pinmode-by/sumo-start-module/README.md

# Стартовый модуль и судейский пульт

#### В этом репозитории вы найдете необходимые материалы для самостоятельного изготовления стартового модуля и судейского пульта стандарта Robotchallenge. Оборудование соответствует требованиям многих мировых соревнований:
+ Robotchallenge (Китай)
+ Robochallenge (Румыния)
+ Robotex (Эстония, Кипр, Турция, Индия, Греция, Китай)
+ Робофинист (Россия)
+ Кубок по образовательной робототехнике (Беларусь)

Используется ИК-канал связи на частоте 38 кГц и протокол RC-5

## [DIY_edition](/DIY_edition/) - вместо стартового модуля используется датчик TSOP xx38, а пульт собирается на Arduino nano
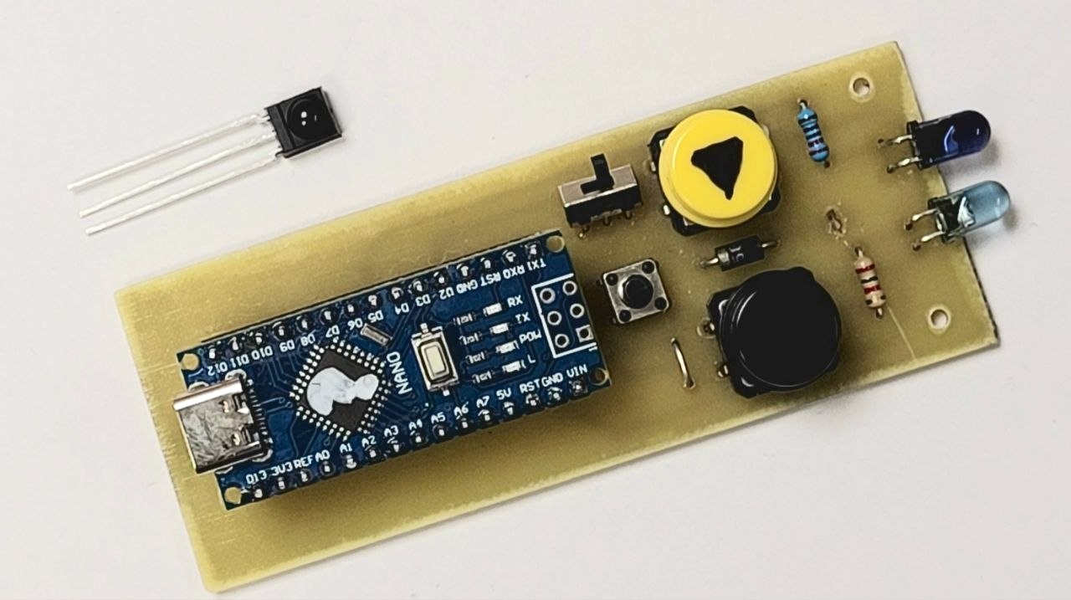
[picture p1: DIY_edition/Referee_remote/Hardware/img/TSOP_and_DIY_referee_RC.jpg]


## [pinMode_edition](/pinMode_edition/) - модуль и пульт, разработанные в клубе pinMode (Беларусь)
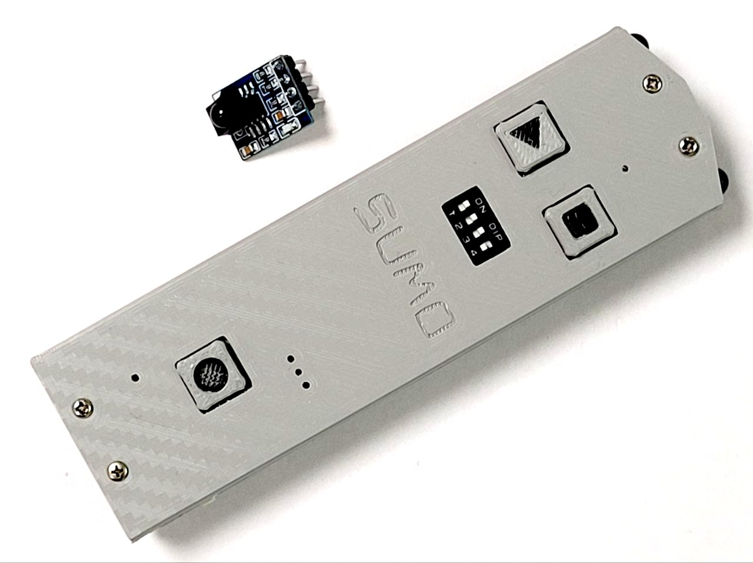
[picture p2: pinMode_edition/Referee_remote/Hardware/img/photo_pinMode_module_and_RC.jpg]

Печатные платы можно заказать на производстве, запаять, прошить их.
