pinmode-by/sumo-start-module/DIY_edition/Readme.md

# [Стартовый модуль](/DIY_edition/Hardware/tsop48.pdf) представляет собой ИК-приемник на 38 кГц

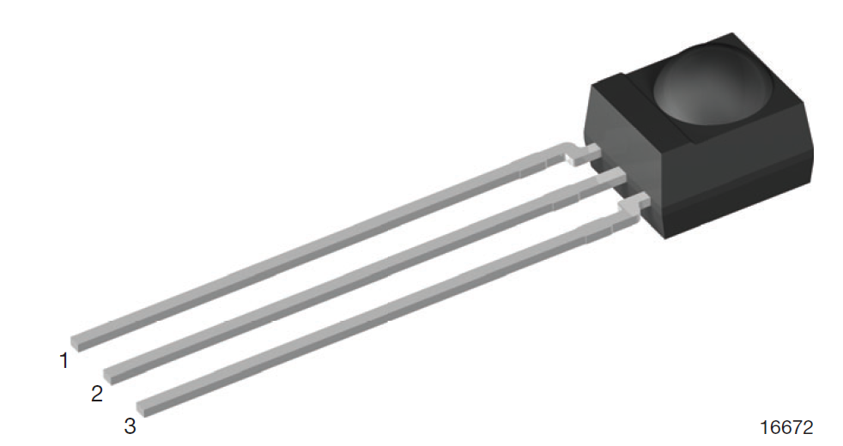
[picture p3: DIY_edition/Hardware/img/TSOP_XX38.png]


[Программа для Arduino IDE](/DIY_edition/Software/TSOP_as_start_module.ino)

-------
# [Судейский пульт](/DIY_edition/Hardware/Schematic_DIY_referee_remote.pdf) на Arduino nano

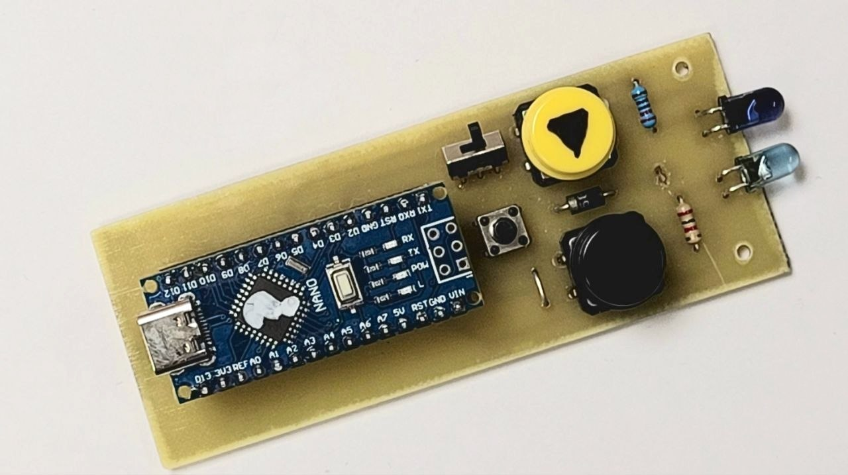
[picture p4: DIY_edition/Referee_remote/Hardware/img/DIY_referee_RC.jpg]


[Программа для Arduino IDE](/DIY_edition/Software/Referee_remote.ino)

| Файл | Назначение |
|---|---|
| [Schematic_DIY_referee_remote.pdf](/DIY_edition/Hardware/Schematic_DIY_referee_remote.pdf)| Принципиальная схема |
| [BOM_DIY_referee_RC.pdf](/DIY_edition/Hardware/BOM_DIY_referee_RC.pdf)| Список деталей |
| [PCB_DIY_Referee_remote_top_layer.pdf](/DIY_edition/Hardware/PCB_DIY_Referee_remote_top_layer.pdf) | Расположение деталей на верхнем слое |
| [PCB_DIY_Referee_remote_bottom_layer.pdf](/DIY_edition/Hardware/PCB_DIY_Referee_remote_bottom_layer.pdf) | Нижний слой платы для ЛУТ |
