pinmode-by/sumo-start-module/pinMode_edition/Start_module/Readme.md

# Стартовый модуль от клуба pinMode

1. Имеет небольшой размер
2. Состоит из доступных компонентов
3. Может запаиваться вручную
4. Совместим по выводам с модулем Robotchallenge

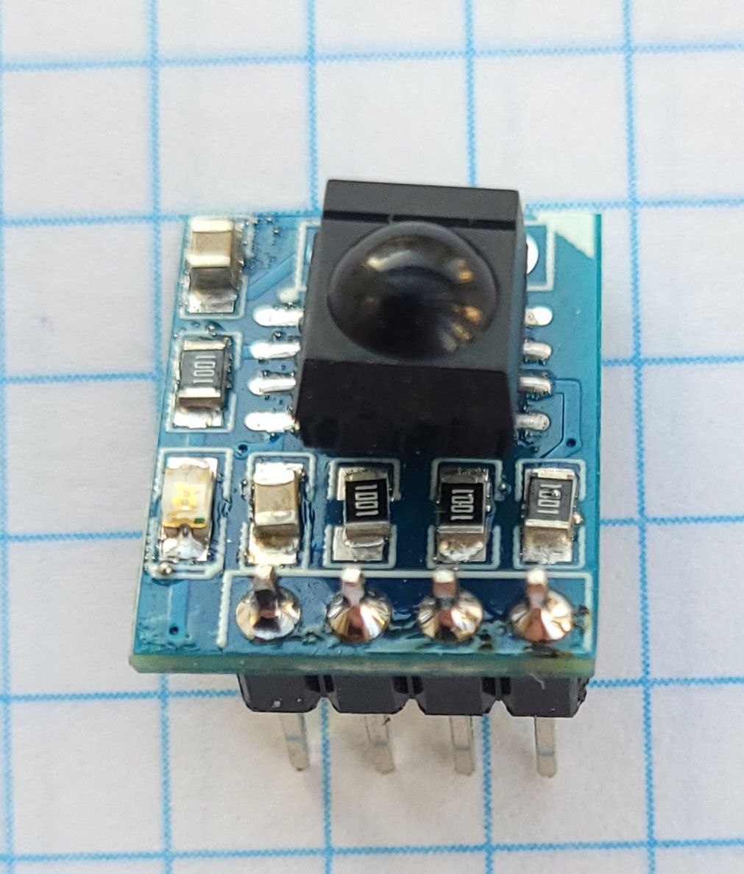
[picture p5: pinMode_edition/Start_module/Hardware/img/Start_module.jpg]


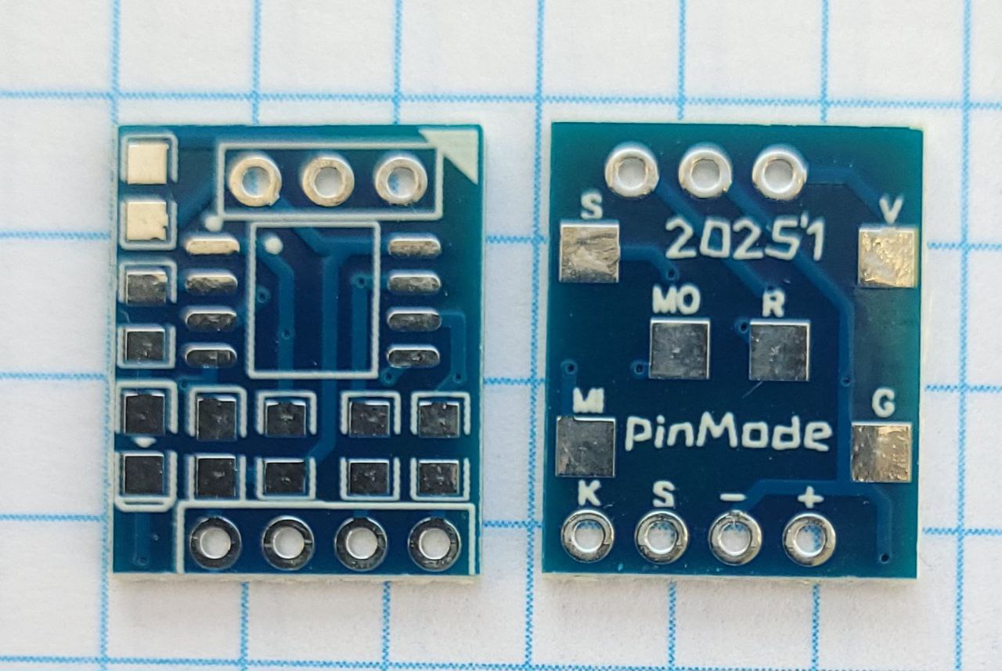
[picture p6: pinMode_edition/Start_module/Hardware/img/PCB_view.jpg]
