pinmode-by/sumo-start-module/pinMode_edition/Referee_remote/Hardware/Readme.md

# Судейский пульт от клуба pinMode

1. Приятно лежит в руке из-за небольших габаритов
2. Имеет 3 мощных ИК-светодиода для запуска и остановки роботов
3. Имеет 1 ИК-светодиод для установки номера ринга
4. Построен на микроконтроллере Atmega168
5. Позволяет выбирать номер ринга от 0 до 15 
6. Работает от LiPo аккумулятора 
7. Имеет зарядное устройство
8. Заряжается через USB type C

| Файл | Содержание |
|---|---|
| [Schematic_Referee_Sumo_RC.pdf](/pinMode_edition/Referee_remote/Hardware/Schematic_Referee_Sumo_RC.pdf) | Принципиальная схема пульта |
| [BOM_Referee_sumo_RC.pdf](/pinMode_edition/Referee_remote/Hardware/BOM_referee_sumo_RC.pdf) | Список компонентов |
| [PickAndPlace_Referee_sumo_RC.pdf](/pinMode_edition/Referee_remote/Hardware/PickAndPlace_Referee_sumo_RC.pdf) | Таблица размещения компонентов|
| [Gerber_Rereree_Sumo_RC.zip](/pinMode_edition/Referee_remote/Hardware/Gerber_Rereree_Sumo_RC.zip)| Gerber-файл для производства|
