pinmode-by/sumo-start-module/pinMode_edition/Start_module/Hardware/readme.md

# RobotChallenge start module by pinMode:

!\[PCB view](/pinMode\_edition/Start\_module/Hardware/img/PCB\_view.jpg)

!\[Module view](/Hardware/Prebuilt\_Module/pinMode\_edition/img/Start\_module.jpg)
