pinmode-by/sumo-start-module/pinMode_edition/Start_module/Hardware/Start_module_eng.pdf

## RobotChallenge sumo start module by pinMode.by

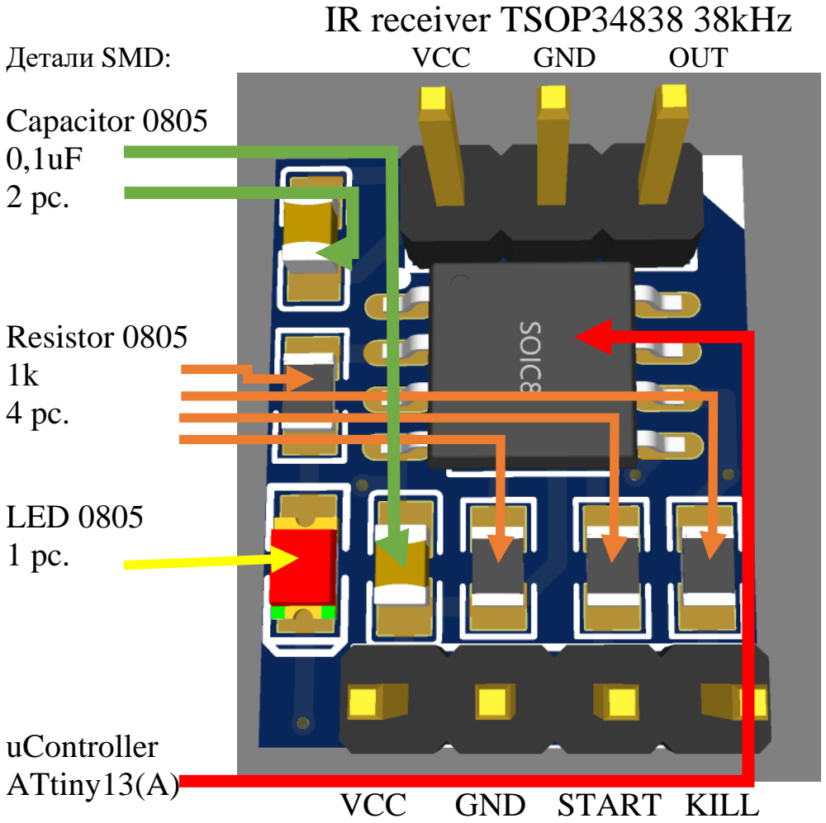
[picture p7: figure]
IR receiver TSOP34838 38kHz; Детали SMD:; VCC; GND; OUT; Capacitor 0805 0,1uF 2 pc.; Resistor 0805 1k 4 pc.; LED 0805 1 pc.; uController; ATtiny13(A); GND START KILL
