pinmode-by/sumo-start-module/pinMode_edition/Start_module/Hardware/Start_module_rus.pdf

## Стартовый модуль микро-, мини- и мега- сумо

## по регламету RobotChallenge

Модуль разработан как замена стандартному https://p1r.se/startmodule/ с использованием доступных в 2025 году деталей

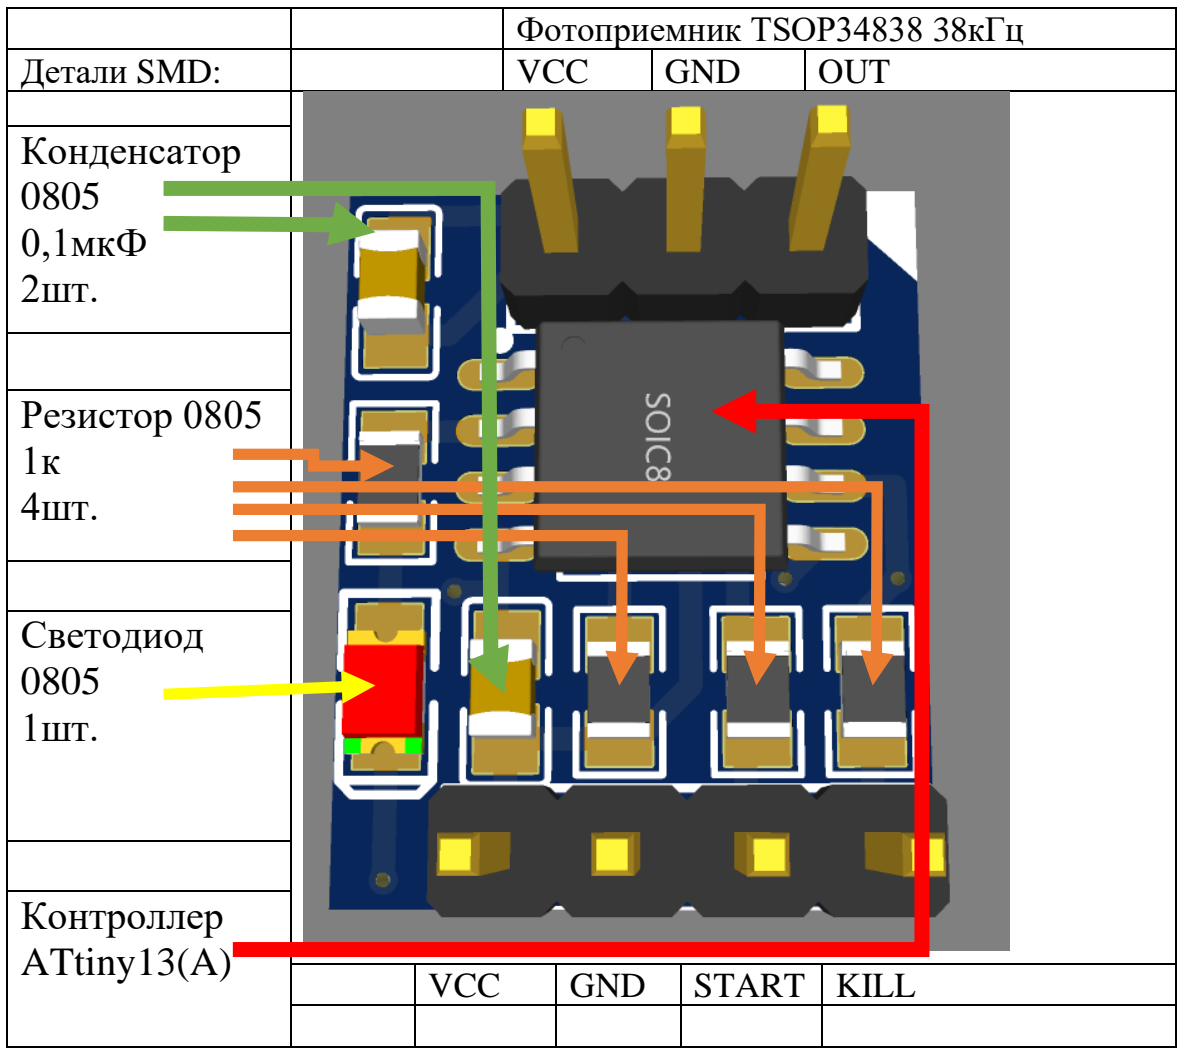
[picture p8: figure]
Фотоприемник TSOP34838 38кГц; Детали SMD:; VCC; GND; OUT; Конденсатор 0805 0,1мкФ 2шт.; Резистор 0805 1к 4шт.; Светодиод 0805 1шт.; Контроллер; ATtiny13(A); START; KILL
