pinmode-by/sumo-start-module/pinMode_edition/Readme.md

# [Стартовый модуль](/pinMode_edition/Start_module/) и [судейский пульт](/pinMode_edition/Referee_remote/) от клуба pinMode



1. Соответствуют международным регламентам
2. Печатные платы изготавливаются промышленным способом
3. Построены из доступных компонентов
4. Возможна ручная сборка (детали не меньше 0805)
