pinmode-by/sumo-start-module/pinMode_edition/Referee_remote/Readme.md

# Судейский пульт от клуба pinMode
* [Оборудование](/pinMode_edition/Referee_remote/Hardware/)
* [Программное обеспечение](/pinMode_edition/Referee_remote/Software/)

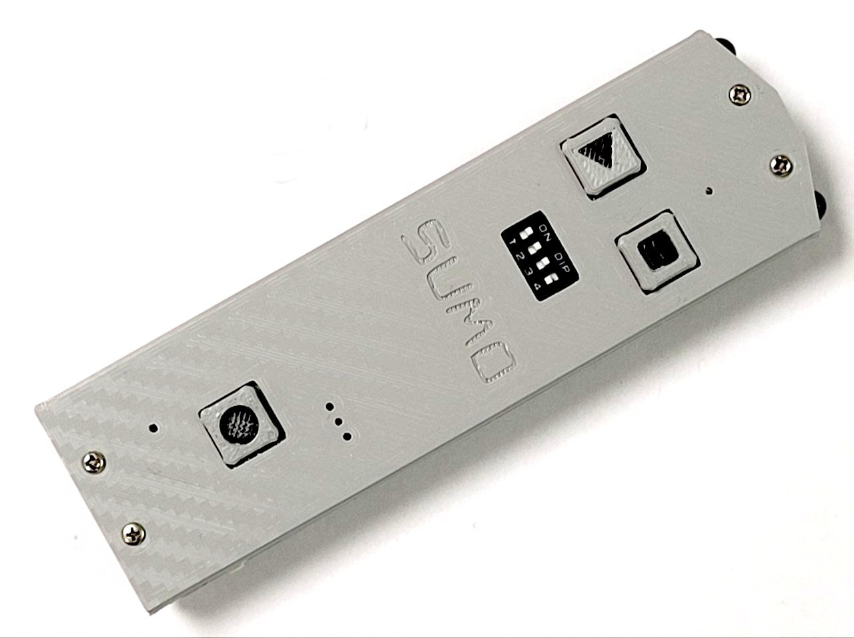
[picture p9: pinMode_edition/Referee_remote/Hardware/img/photo_pinMode_RC.jpg]
