pinmode-by/sumo-start-module/DIY_edition/Referee_remote/Hardware/DIY_Referee_remote.png

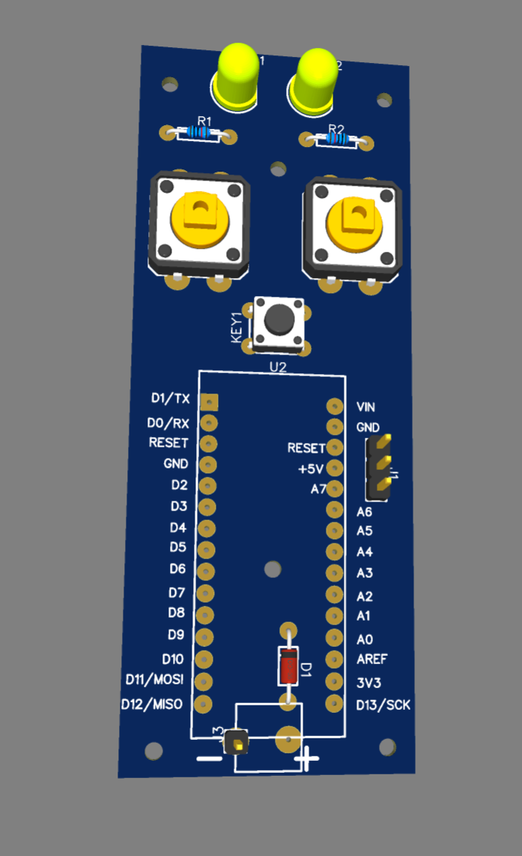
DIY_edition/Referee_remote/Hardware/DIY_Referee_remote.png
