pinmode-by/sumo-start-module/DIY_edition/Referee_remote/Hardware/img/photo_DIY_module_and_RC.jpg

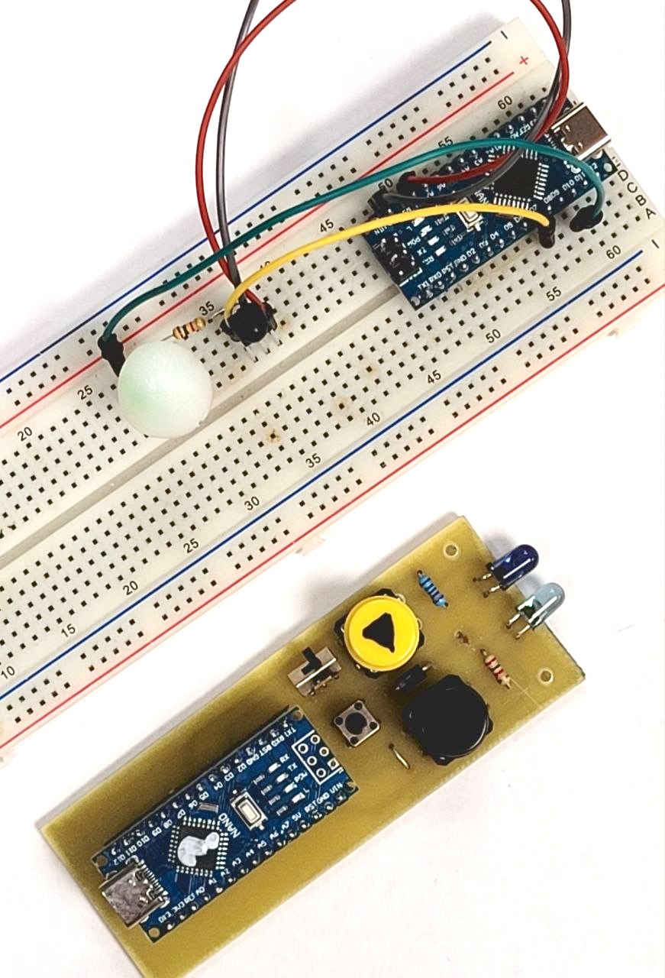
DIY_edition/Referee_remote/Hardware/img/photo_DIY_module_and_RC.jpg
