pinmode-by/sumo-start-module/pinMode_edition/Referee_remote/Hardware/img/photo_Device.jpg

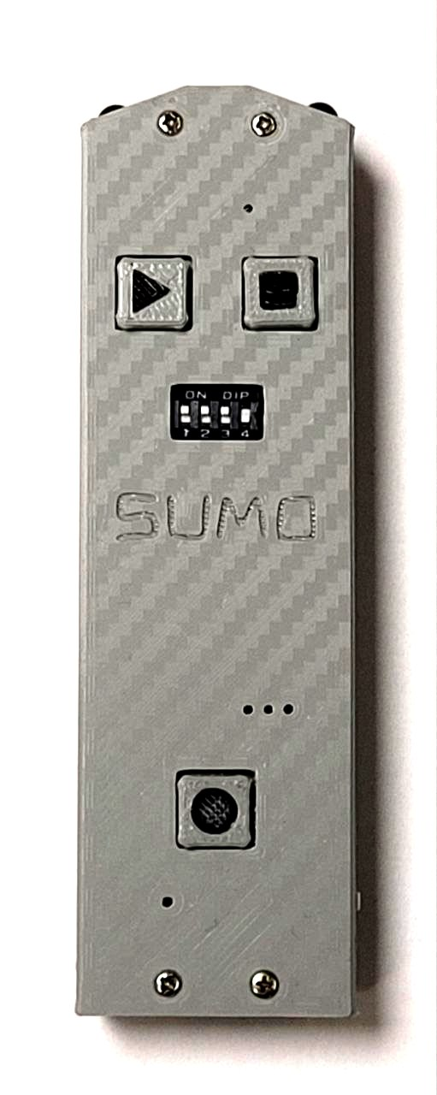
pinMode_edition/Referee_remote/Hardware/img/photo_Device.jpg
