pinmode-by/sumo-start-module/pinMode_edition/Referee_remote/Hardware/img/photo_PCB_Referee_sumo_RC.jpg

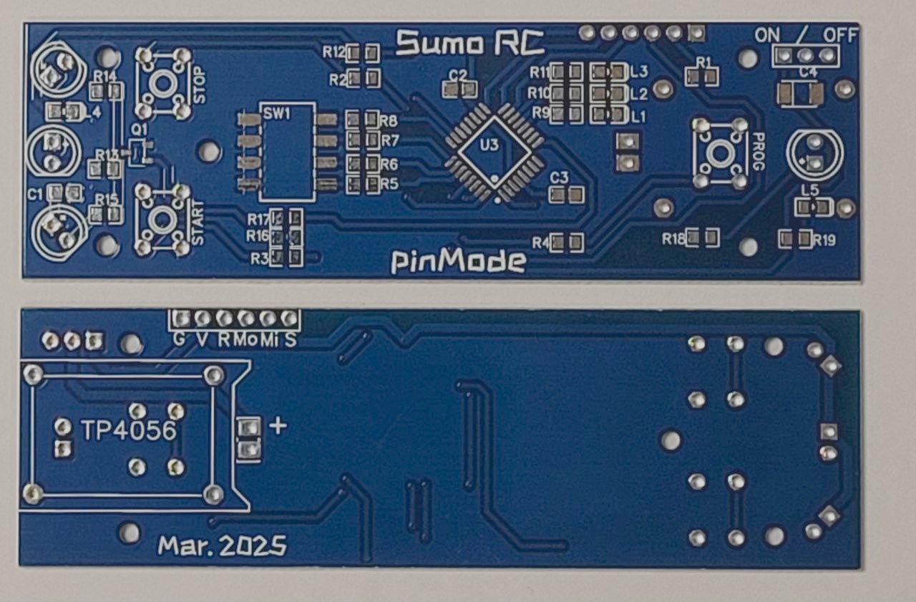
pinMode_edition/Referee_remote/Hardware/img/photo_PCB_Referee_sumo_RC.jpg
