pinmode-by/sumo-start-module/pinMode_edition/Start_module/Hardware/Programmer/photo_Start_module_Programmer.jpg

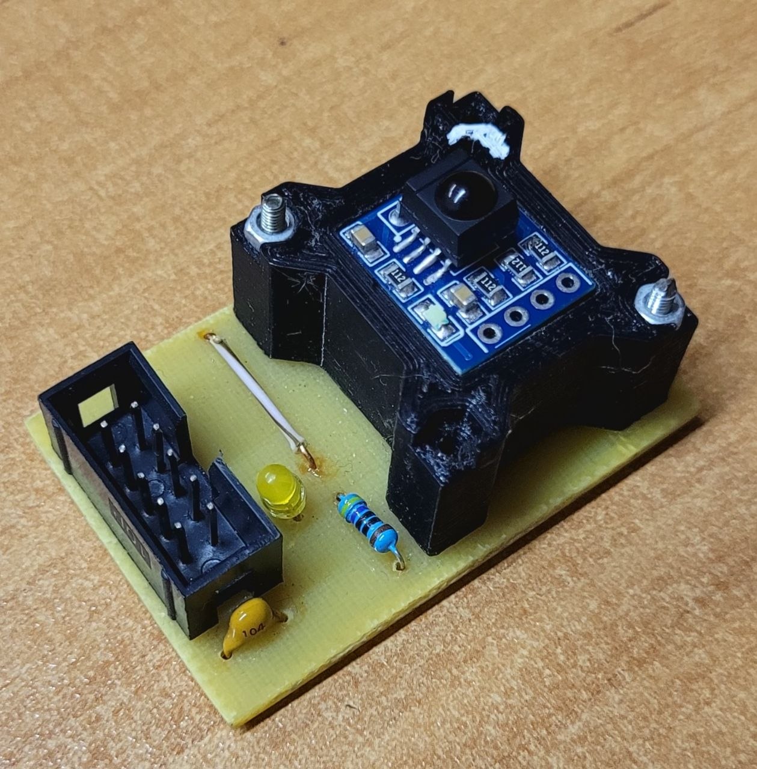
pinMode_edition/Start_module/Hardware/Programmer/photo_Start_module_Programmer.jpg
