pinmode-by/sumo-start-module/pinMode_edition/Start_module/Hardware/start_module.png

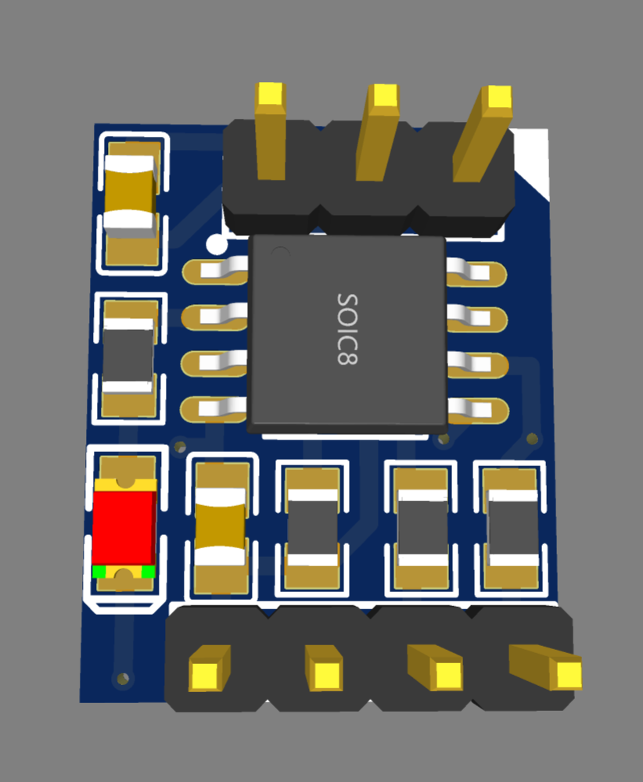
pinMode_edition/Start_module/Hardware/start_module.png
