pinmode-by/sumo-start-module/DIY_edition/Hardware/BOM_DIY_referee_RC.pdf

ID | Name | Designator | Footprint | Quantity
1 1N4148 | | D1 | DO-35 | 1
2 HDR-M-2.54_1x1 | | J3 | HDR-M-2.54_1X1 | 1
3 HDR-M-2.54_1x3 | | J1 | HDR-M-2.54_1X3 | 1
4 K4-6×6_TH | | KEY1 | KEY-TH_4P-L6.0-W6.0-P4.50 | 1
5 K4-12×12_TH | | KEY2,KEY3 | KEY-TH_4P-L12.0-W12.0-P5.00 | 2
6 TSAL6400 | | LED1,LED2 | LED-TH_BD5.8-P2.54-FD | 2
7 220R | | R1 | R_AXIAL-0.3 | 1
8 2k2 | | R2 | R_AXIAL-0.3 | 1
9 ARDUINO_NANO | | U2 | ARDUINO_NANO | 1
