pinmode-by/sumo-start-module/pinMode_edition/Referee_remote/Hardware/BOM_referee_sumo_RC.pdf

ID | Name | Designator | Footprint | Quantity
1 TP4056 | | TP | | 1
2 10u | | C4 | CASE-B_3528 | 1
3 LED-0805_R | | L5,L1 | LED0805_RED | 2
4 10k | | R19,R1 | R0805 | 2
5 ATMEGA168PB-ANU3 | | | TQFP-32_L7.0-W7.0-P0.80-LS9.0-BL | 1
6 4.7k | | R3,R2,R4,R16 | R0805 | 4
7 1k | | R12,R9,R10,R11 | R0805 | 4
8 0.1u | | C3,C2 | C0805 | 2
9 1u | | C1 | C0805 | 1
10 TSAL6100 | | IR_LEDS,U2,U4,U5 | LED-TH_BD5.8-P2.54-FD | 4
11 K4-6×6_TH | | STOP,START,PROG | KEY-TH_4P-L6.0-W6.0-P4.50-LS6.5 | 3
12 LED-0805_G | | L2 | LED0805_GREEN | 1
13 LED-0805 | | L4 | LED0805_GREEN | 1
14 LED-0805_B | | L3 | LED0805_BLUE | 1
15 MainSW | | ON_/_OFF | HDR-3X1/2.54 | 1
16 AO3400-SOT23-3LQ1 | | | SOT-23-3_L2.9-W1.6-P1.90-LS2.8-BR | 1
17 4k | | R5,R6,R7,R8 | R0805 | 4
18 2R2 | | R13,R14,R15 | R0805 | 3
19 220R | | R17,R18 | R0805 | 2
20 DM-04-V-T/R COPYSW1 | | | DIPSWITCH-04-SMD | 1
21 HDR-M-2.54_1x6 J3 | | | HDR-M-2.54_1X6 | 1
22 LiPo_1s | | J2 | HDR-M-2.54_1X2 | 1
