pinmode-by/sumo-start-module/pinMode_edition/Start_module/Hardware/Components_pinMode.pdf

Name in schematic | Amount per board | Component | Package | Value | Link
uC | 1 | ATTINY13A | SOIC-8 | Atmel Microcontroller | https://belchip.by/product/?selected_product=19050
IR | 1 | IR-receiver | TH-3P | TSOP34838, 38kHz | https://belchip.by/product/?selected_product=19022
LED | 1 | Blue led | 0805 | | https://belchip.by/product/?selected_product=55123
C1,C2 | 2 | Capacitance | 0805 | 0,1uf | https://belchip.by/product/?selected_product=54336
R1,R2,R3,R4 | 4 | Resistance | 0805 | 1k | https://belchip.by/product/?selected_product=18528
