pinmode-by/sumo-start-module/pinMode_edition/Start_module/Hardware/BOM_Sumo_start_module_2026-11-08.csv

ID | Name | Designator | Footprint | Quantity
1 | 0,1u | C1,C2 | C0805 | 2
2 | HDR-M-2.54_1x4 | J1 | HDR-M-2.54_1X4 | 1
3 | LED-0805_R | LED1 | LED0805_RED | 1
4 | 1k | R1,R2,R3,R4 | R0805 | 4
5 | ATTINY13A-SN | U1 | SOIC-8_L5.3-W5.3-P1.27-LS8.0-BL | 1
6 | HDR-M-2.54_1x3 | TSOP | HDR-M-2.54_1X3 | 1
