pinmode-by/sumo-start-module/pinMode_edition/Referee_remote/Hardware/Schematic_Referee_Sumo_RC.pdf

TP4056

# Power

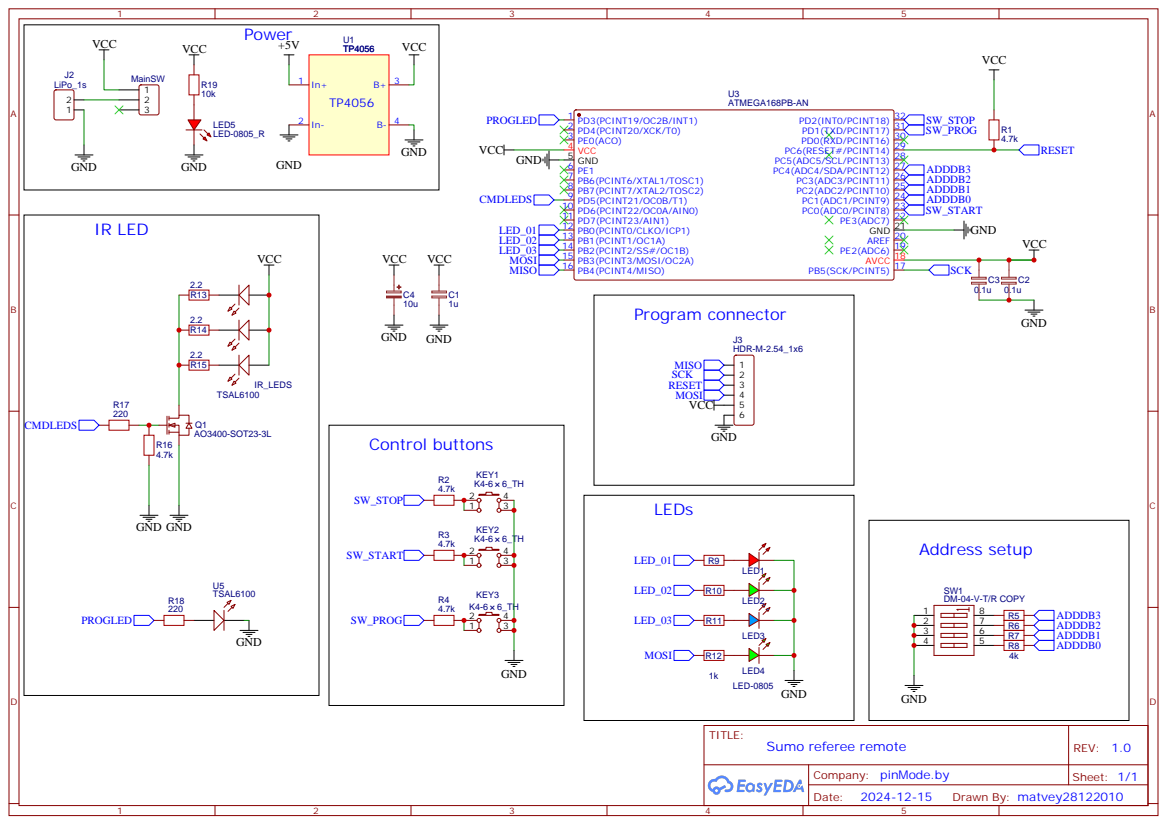
[picture p16: page 1]
