pinmode-by/sumo-start-module/pinMode_edition/Start_module/Hardware/Schematic_Sumo_start_module_2026-11-08-1.pdf

IR

## GND

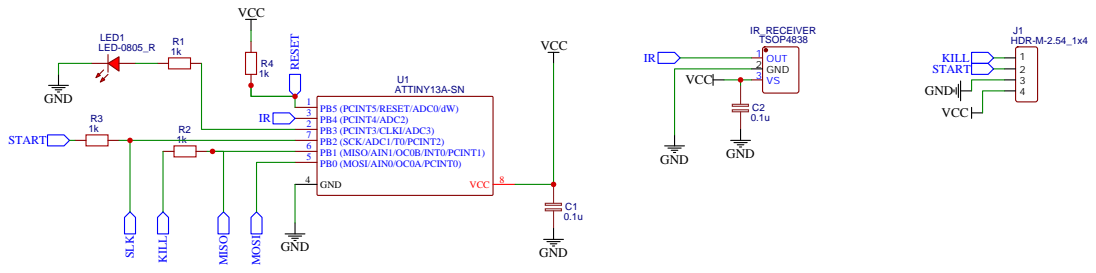
[picture p17: page 1]
