pinmode-by/sumo-start-module/DIY_edition/Referee_remote/Hardware/PCB_DIY_Referee_remote_bottom_layer.pdf

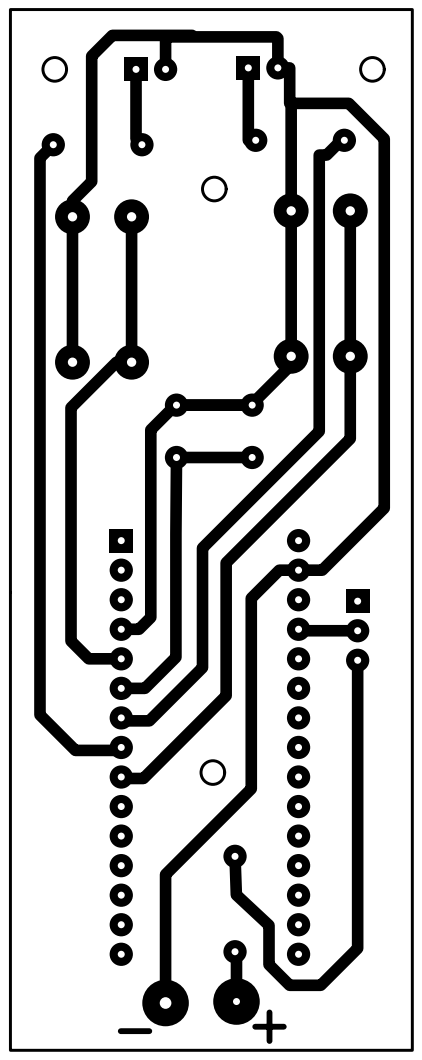
[picture p18: page 1]
