pinmode-by/sumo-start-module/DIY_edition/Referee_remote/Hardware/PCB_DIY_Referee_remote_top_layer.pdf

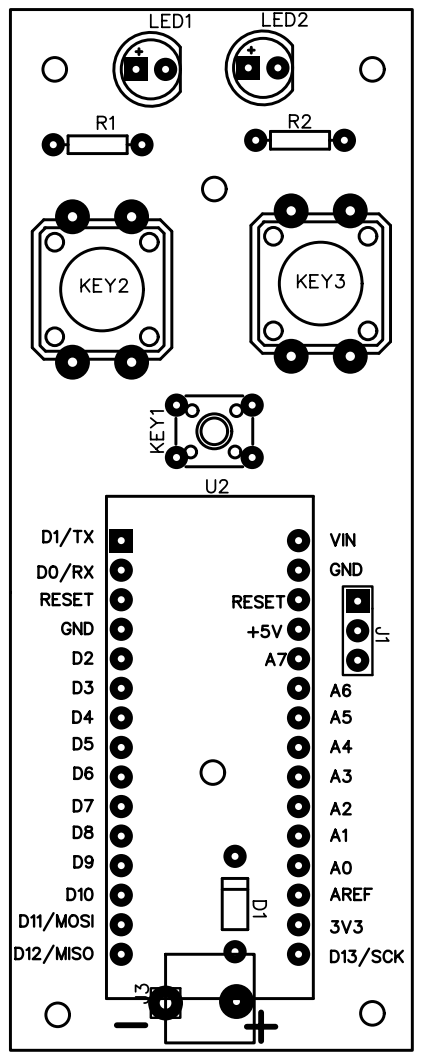
[picture p19: page 1]
