pinmode-by/sumo-start-module/DIY_edition/Referee_remote/Hardware/Schematic_DIY_referee_remote.pdf

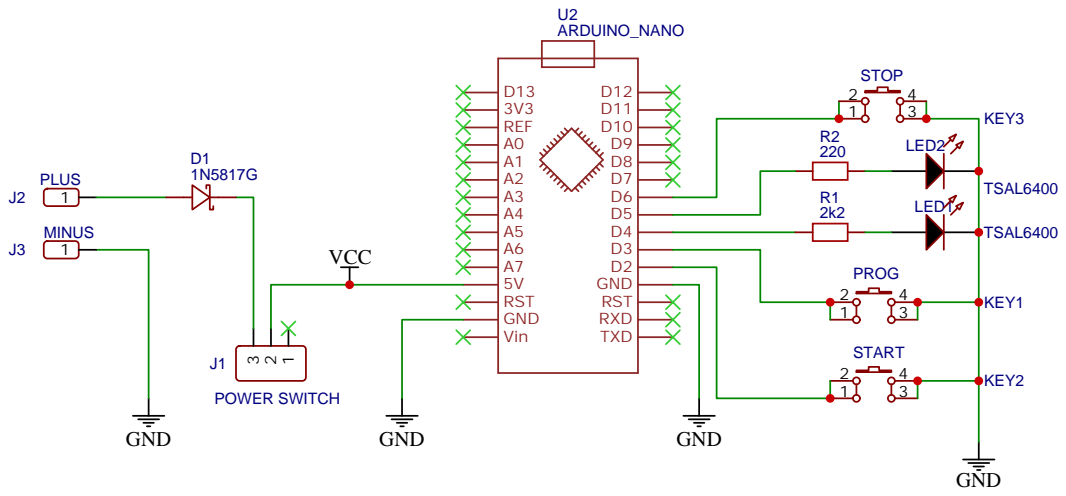
[picture p20: page 1]
