pinmode-by/sumo-start-module/pinMode_edition/Start_module/Hardware/PCB_Sumo_start_module-bottom.pdf

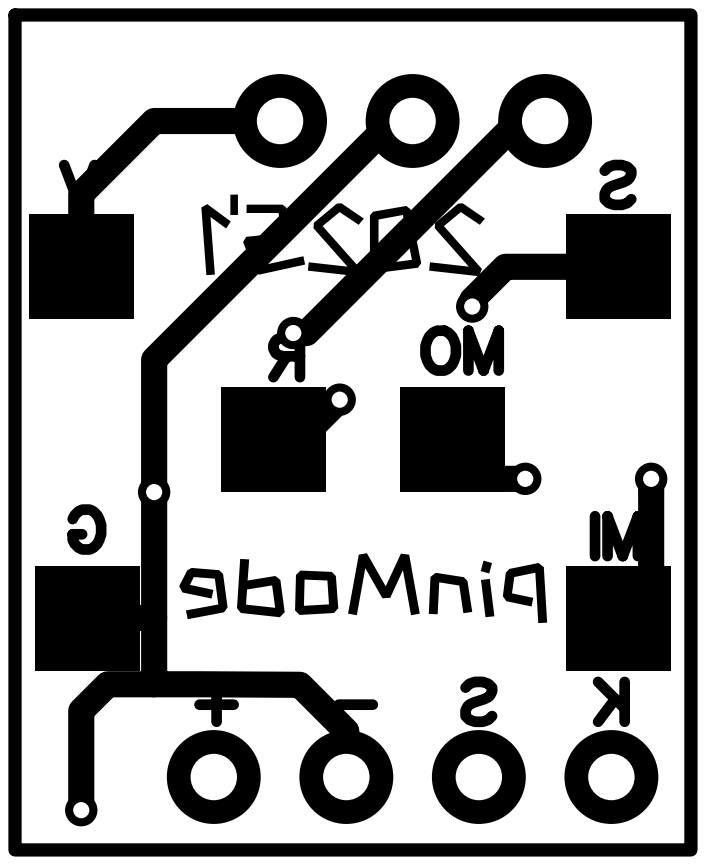
[picture p21: page 1]
