pinmode-by/sumo-start-module/pinMode_edition/Start_module/Hardware/PCB_Sumo_start_module-top.pdf

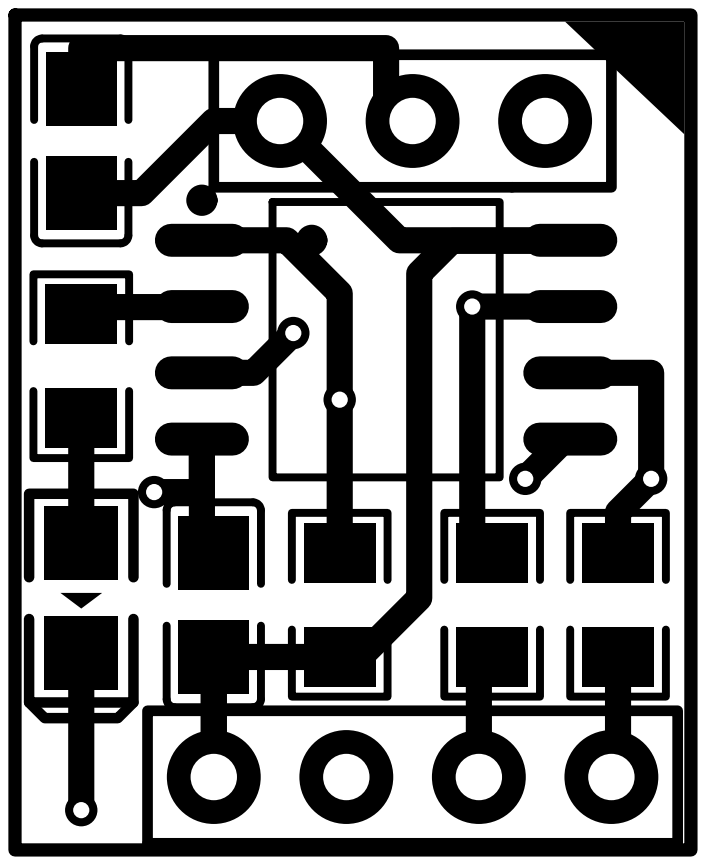
[picture p22: page 1]
