pinmode-by/sumo-start-module/pinMode_edition/Start_module/Hardware/Programmer/PCB_start_module_programmer.pdf

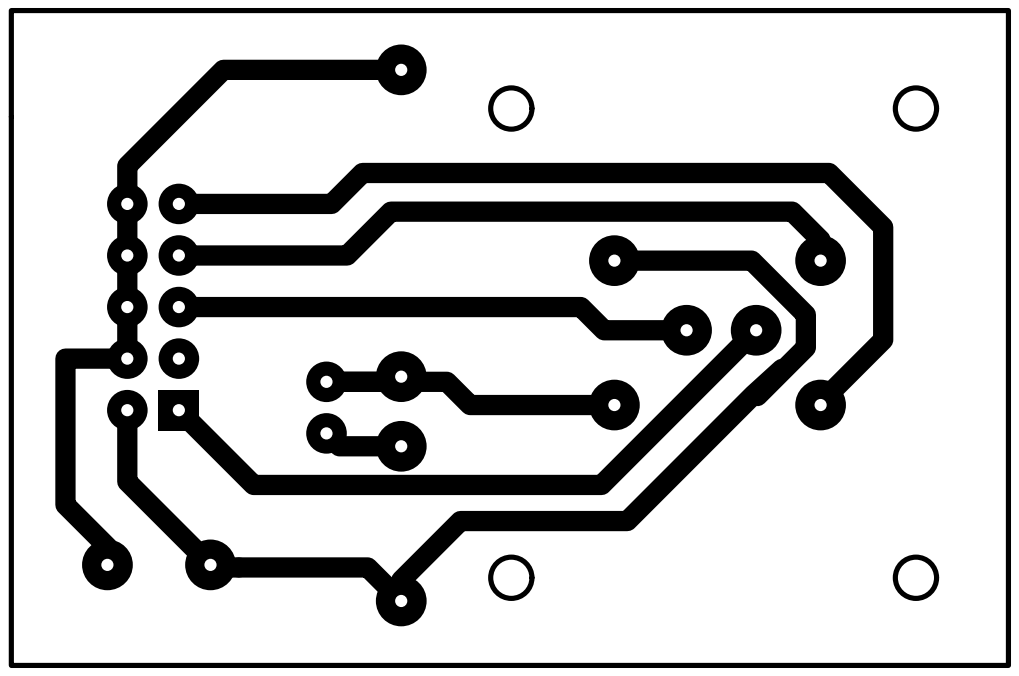
[picture p23: page 1]
