pinmode-by/sumo-start-module/pinMode_edition/Start_module/Hardware/Programmer/PCB_start_module_programmer_top.pdf

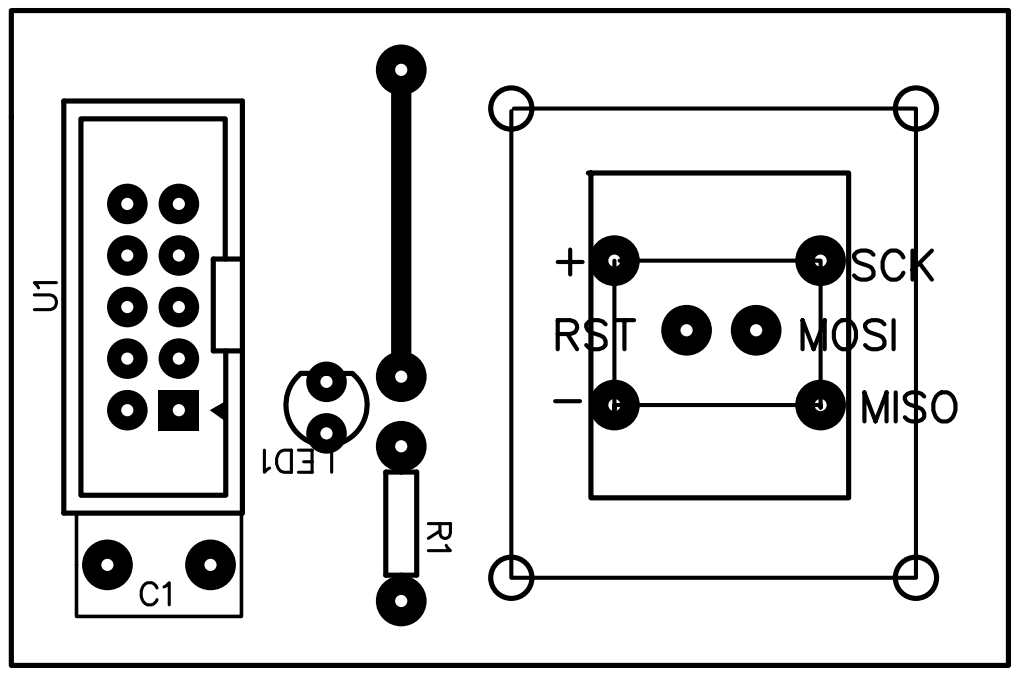
[picture p24: page 1]
