pinmode-by/sumo-start-module/pinMode_edition/Start_module/Hardware/Programmer/Schematic_start_module_programmer_2026-11-09.pdf

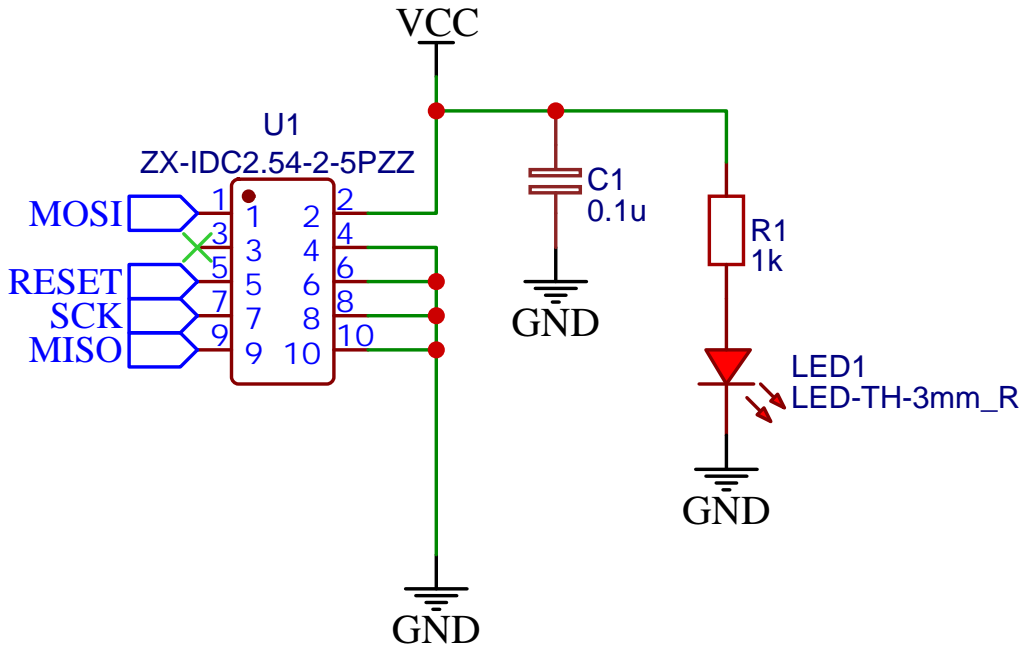
[picture p25: page 1]
