pinmode-by/sumo-start-module/pinMode_edition/Referee_remote/Hardware/img/photo_Assembled_PCB_top.jpg

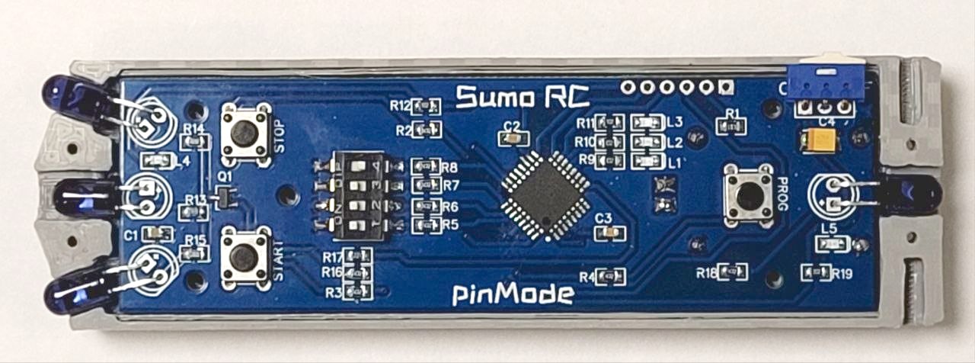
pinMode_edition/Referee_remote/Hardware/img/photo_Assembled_PCB_top.jpg
